Kempf/rectifier/report.pdf

# ENGN1218 Introduction to Electronics Full-wave Rectifier Analysis

Paul Apelt, u5568225 | Thomas Hale, u5567957

### School of Engineering, ANU

### October 23, 2014

Abstract

A diode-bridge full wave power rectifier circuit was designed and constructed. The aim was to achieve a 12V DC output with 10% tolerance. A theoretical analysis of two types of diode-bridge full-wave rectifiers—with and without a capacitor—was conducted, and results confirmed using a computer simulation. The construction process was documented, and all output parameters measured. The aim was successfully achieved, with all output parameters matching the predicted values within an acceptable error bound.

## 1 Introduction

Most forms of power are supplied in the form of AC current.As most electronics devices and systems require DC current it is necessary that there be a means to convert AC to DC. Power rectifier circuits allow this and function using diodes, which ideally only allow the passage of current in one direction - typically the positive direction.
There are several types of rectifier circuits that can be used to convert from AC to DC current but only the full wave rectifier or bridge rectifier will be discussed in this report. The bridge rectifier circuit—as per Figure 1a—is designed such that current during both the negative and positive cycles pass through the load site in the same direction, which means that the voltage across the load site is always of the same sign. Although this configuration of diodes succeeds in inverting the voltage in the negative cycle, the voltage is not the constant DC voltage that is desired. In order to reduce this voltage variation a capacitor is added in series with the load site. The capacitor charges when the voltage from the source is increasing and discharges when the voltage from the source is decreasing, thus smoothing the output waveform.

## 2 Theoretical Analysis

Two versions of a full-wave rectifier circuit were analysed, with and without a smoothing capacitor, schematics shown in Figures 1a and 1b respectively.

1


(a) Full-wave rectifier with a capacitor filter. | (b) Full-wave rectifier without a capacitor filter.

Figure 1: Schematics.

To predict the output of the rectifier circuit, formulas from the lecture notes were used (Kim). The value for the input voltage Vin

1 was taken to be equal to the actual output of the transformer used during testing (see Section 4). The output voltage of a rectifier without a capacitor filter was calculated in Equation 1, and the voltage ripple of the output of the rectifier with a smoothing capacitor—in Equation 2.

Vout = Vin − 2 × 0.7

= 18.8 − 1.4

= 17.4V

(1)

Note that in the above case, in the absence of the smoothing capacitor, Vr = Vout. The addition of a capacitor has no effect on the output peak voltage, but decreases ripple.
(
Vr =

VDC
2fRLC
VDC = Vout −
1/2 Vr

⇔ Vr =

2Vout
4fRLC + 1

=

2 × 17.4
4 × 50 × 2.2 × 10³ × 10⁻⁴ + 1 = 0.773V

(2)

## 3 Simulation

## 4 Implementation

## 5 Discussion

## 6 Conclusion

## References

Jon Kim. ENGN1218 intro to electronics: Response of RC and RL circuits. Lecture 11.

1Unless explicitly stated otherwise, all AC voltage values are peak-to-peak.

2
