Kempf/rectifier/pcb_front.jpg

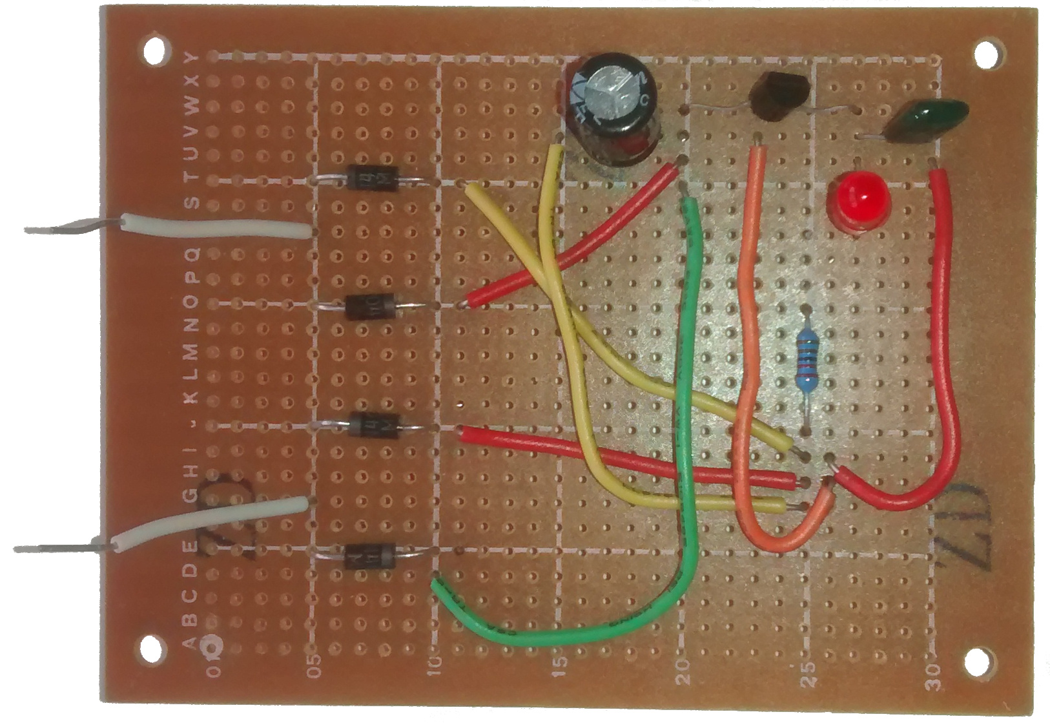
pcb_front.jpg
