Kempf/rectifier/(commit log)

2014-10-22 Push local report files
    [rekt_cap.sch, rekt_nocap.sch]
2014-10-23 Added simulation
    [rekt_reg.sch]
